tacaro/OpenWGL/designs/OpenWGL_PINOUT.pdf

# OpenWGL 2024

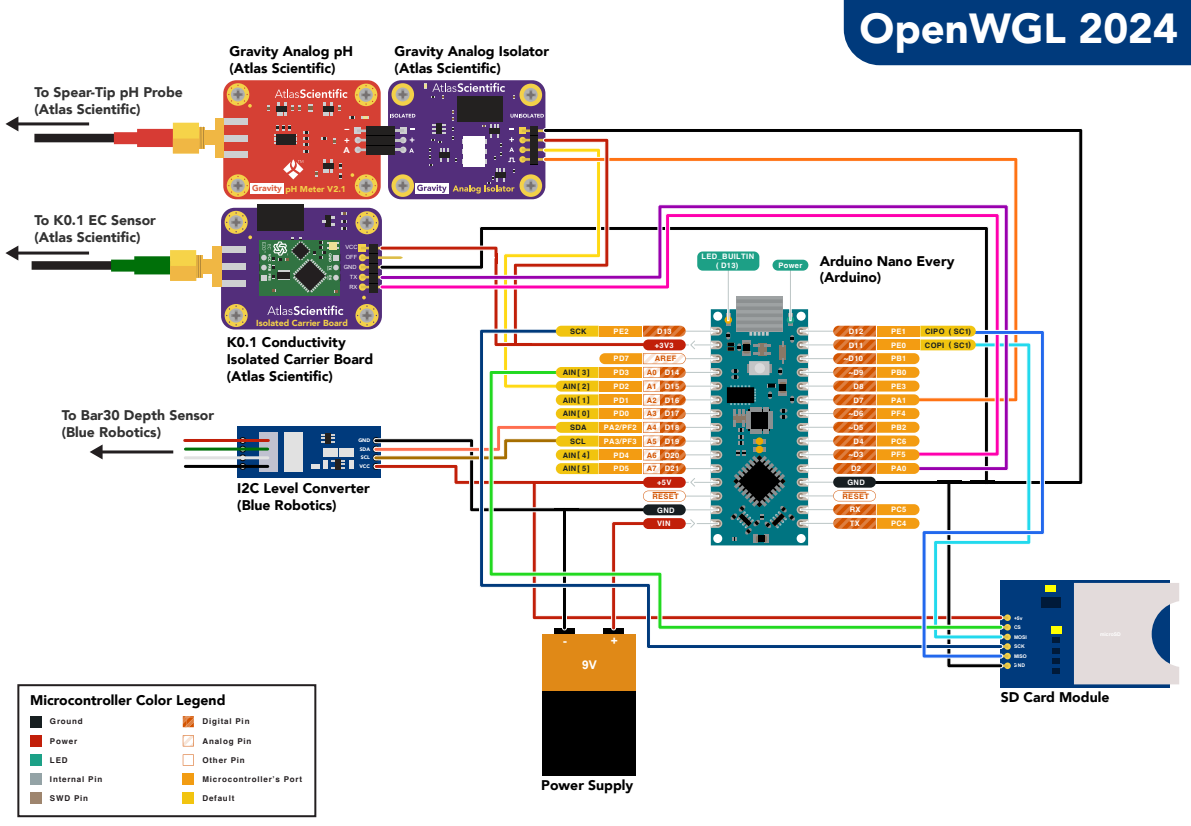
[picture p4: page 1]

To Spear-Tip pH Probe
(Atlas Scientific)
