tacaro/OpenWGL/(commit log)

2024-02-23 Pin map in the comments
2024-03-01 data commit
    [NSHQ14_29Feb24_fixed.csv]
